matthewdias/solstice/README.md

# solstice
 
40s mods drop-in pcb for equinox

 
 
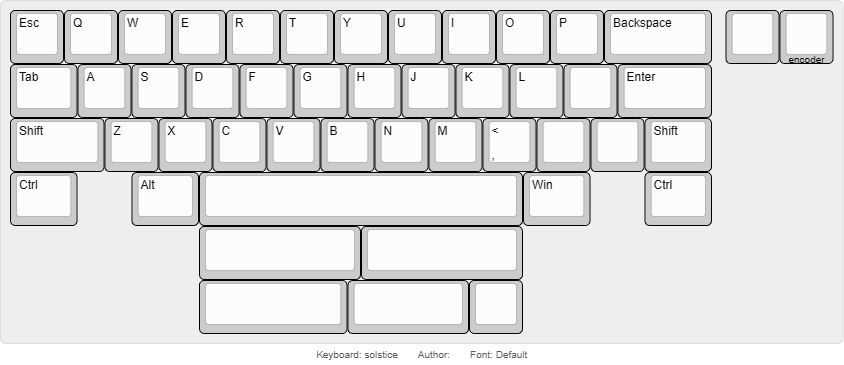
[picture p1: Images/keyboard-layout.png]
