matthewdias/solstice/EquinoxPCB_1.dxf

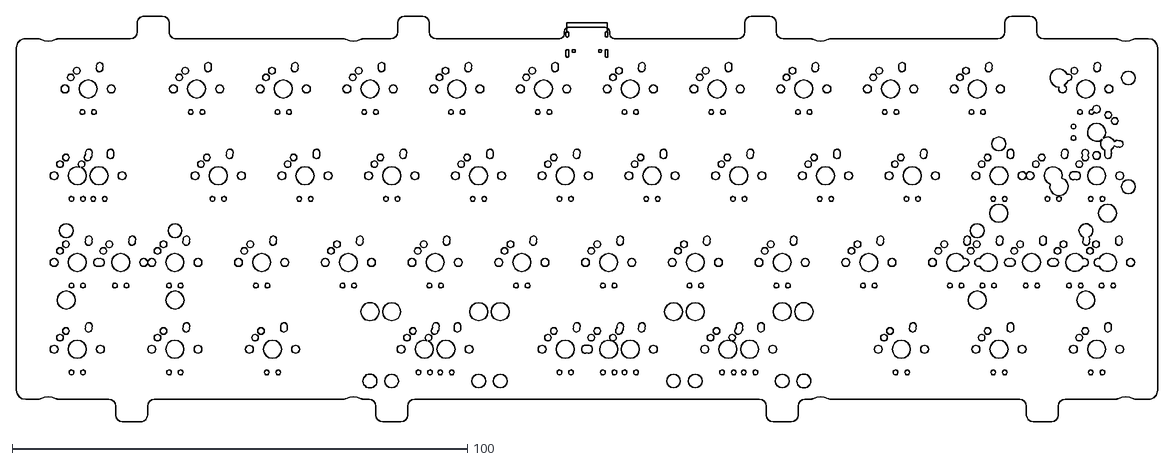
[picture p2: CAD file, 2024-12-08]
EquinoxPCB_1.dxf
250.6 x 89.2
