matthewdias/solstice/solstice.kicad_pcb

## KiCad design solstice.kicad_pcb (2024-12-08)

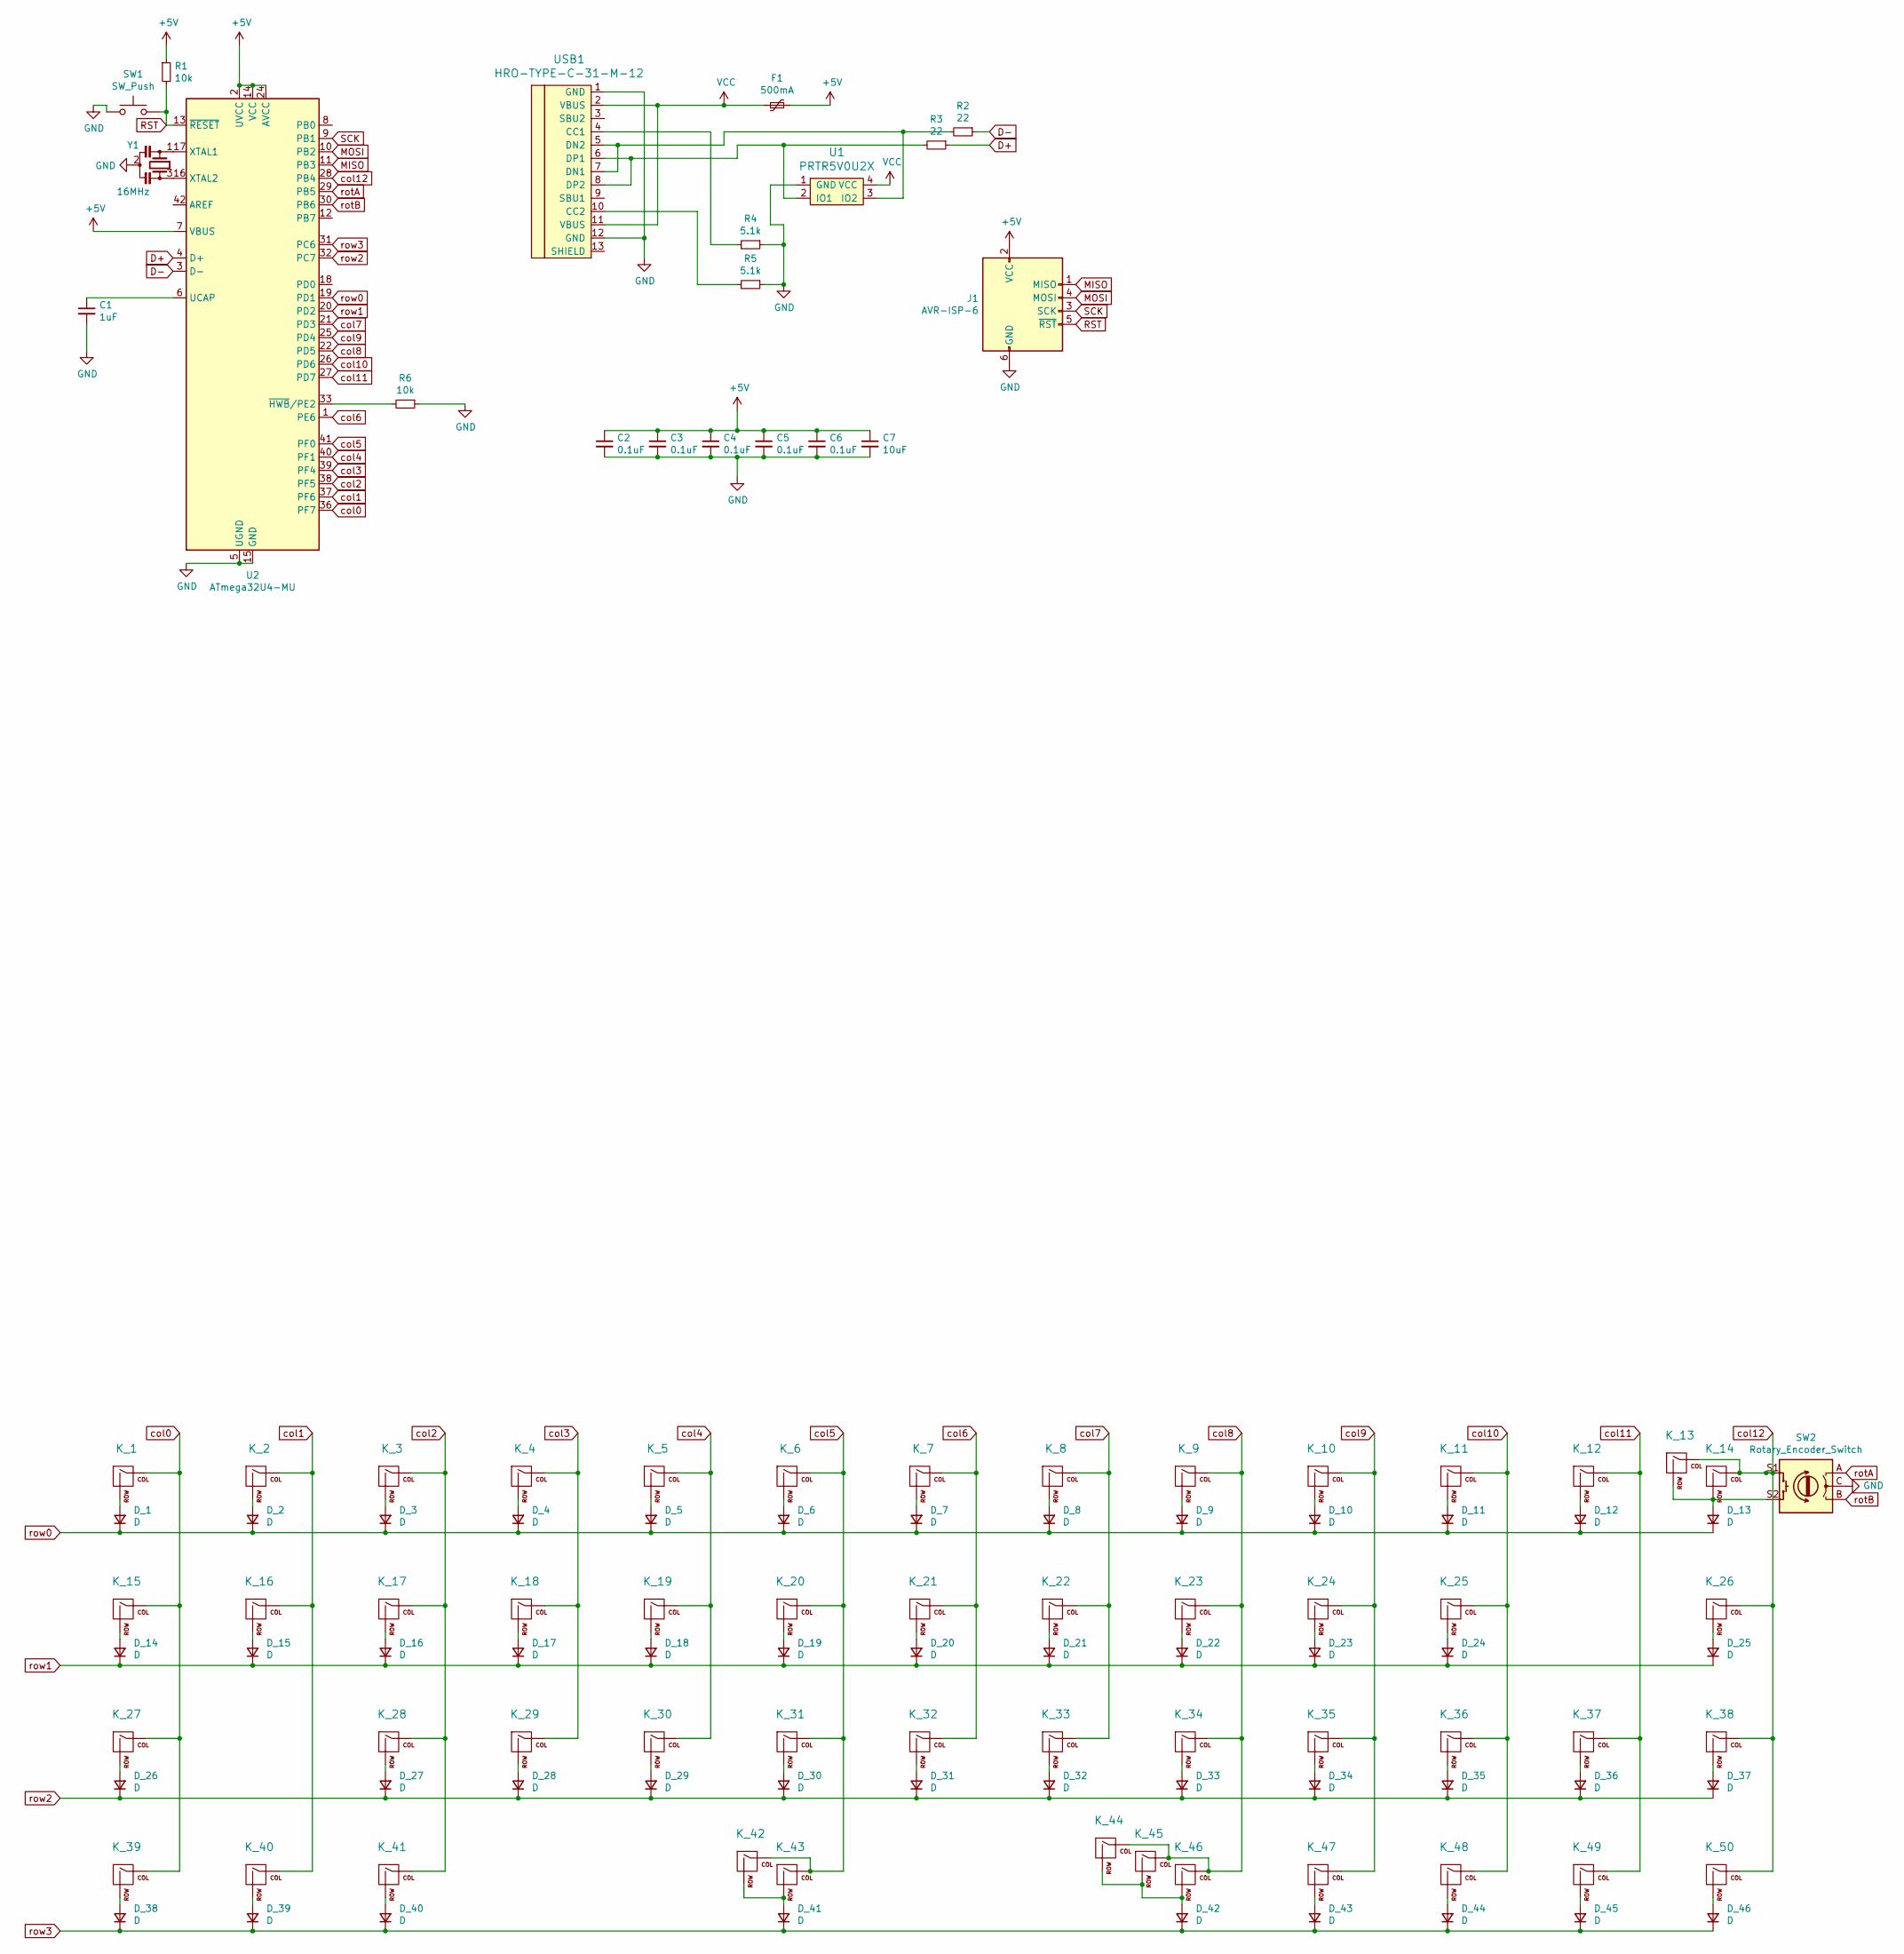
[picture p3: schematic solstice.sch]

Parts:
C1: 1uF; C_0603_1608Metric
C2, C3, C4, C5, C6: 0.1uF; C_0603_1608Metric
C7: 10uF; C_0603_1608Metric
D_1, D_2, D_3, D_4, D_5, D_6, D_7, D_8, D_9, D_10, D_11, D_12, D_13, D_14, D_15, D_16, D_17, D_18, D_19, D_20, D_21, D_22, D_23, D_24, D_25, D_26, D_27, D_28, D_29, D_30, D_31, D_32, D_33, D_34, D_35, D_36, D_37, D_38, D_39, D_40, D_41, D_42, D_43, D_44, D_45, D_46: D; D_SOD-123
F1: 500mA; Fuse_1206_3216Metric
J1: AVR-ISP-6; ISP-Staggered
K_1, K_2, K_3, K_4, K_5, K_6, K_7, K_8, K_9, K_10, K_11, K_12, K_14, K_16, K_17, K_18, K_19, K_20, K_21, K_22, K_23, K_24, K_25, K_28, K_29, K_30, K_31, K_32, K_33, K_34, K_35, K_36, K_37, K_40, K_47, K_49: KEYSW; MXOnly-1U-NoLED
K_13: KEYSW; MXOnly-2U-NoLED
K_15, K_38, K_39, K_41, K_48, K_50: KEYSW; MXOnly-1.25U-NoLED
K_26, K_27: KEYSW; MXOnly-1.75U-NoLED
K_42: KEYSW; MXOnly-2.75U-ReversedStabilizers-NoLED
K_43, K_46: KEYSW; MXOnly-3U-ReversedStabilizers-NoLED
K_44: KEYSW; MXOnly-6U-Centered-ReversedStabilizers-NoLED
K_45: KEYSW; MXOnly-2.25U-ReversedStabilizers-NoLED
R1, R6: 10k; R_0603_1608Metric
R2, R3: 22; R_0603_1608Metric
R4, R5: 5.1k; R_0603_1608Metric
SW1: SW_Push; SKQG-1155865
SW2: Rotary_Encoder_Switch; RotaryEncoder_Alps_EC11E-Switch_Vertical_H20mm_adjusted
U1: PRTR5V0U2X; SOT143B
U2: ATmega32U4-MU; QFN-44-1EP_7x7mm_P0.5mm_EP5.2x5.2mm
USB1: HRO-TYPE-C-31-M-12; HRO-TYPE-C-31-M-12-Assembly
Y1: 16MHz; Resonator_SMD_muRata_CSTxExxV-3Pin_3.0x1.1mm

Connections:
+5V: C2.1, C3.1, C4.1, C5.1, C6.1, C7.1, F1.1, J1.2 (VCC), R1.1, U2.2 (UVCC), U2.7 (VBUS), U2.14 (VCC), U2.24 (AVCC), U2.34 (VCC), U2.44 (AVCC)
D+: R3.1, U2.4 (D+)
D-: R2.1, U2.3 (D-)
GND: C1.2, C2.2, C3.2, C4.2, C5.2, C6.2, C7.2, J1.6 (GND), R4.1, R5.1, R6.1, SW1.1, SW2.C, U1.1 (GND), U2.5 (UGND), U2.15 (GND), U2.23 (GND), U2.35 (GND), U2.43 (GND), U2.45 (GND), USB1.1 (GND), USB1.12 (GND), Y1.2
MISO: J1.1 (MISO), U2.11 (PB3)
MOSI: J1.4 (MOSI), U2.10 (PB2)
unnamed: C1.1, U2.6 (UCAP)
unnamed: D_1.2 (A), K_1.2 (ROW)
unnamed: D_2.2 (A), K_2.2 (ROW)
unnamed: D_3.2 (A), K_3.2 (ROW)
unnamed: D_4.2 (A), K_4.2 (ROW)
unnamed: D_5.2 (A), K_5.2 (ROW)
unnamed: D_6.2 (A), K_6.2 (ROW)
unnamed: D_7.2 (A), K_7.2 (ROW)
unnamed: D_8.2 (A), K_8.2 (ROW)
unnamed: D_9.2 (A), K_9.2 (ROW)
unnamed: D_10.2 (A), K_10.2 (ROW)
unnamed: D_11.2 (A), K_11.2 (ROW)
unnamed: D_12.2 (A), K_12.2 (ROW)
unnamed: D_13.2 (A), K_13.2 (ROW), K_14.2 (ROW), SW2.S2
unnamed: D_14.2 (A), K_15.2 (ROW)
unnamed: D_15.2 (A), K_16.2 (ROW)
unnamed: D_16.2 (A), K_17.2 (ROW)
unnamed: D_17.2 (A), K_18.2 (ROW)
unnamed: D_18.2 (A), K_19.2 (ROW)
unnamed: D_19.2 (A), K_20.2 (ROW)
unnamed: D_20.2 (A), K_21.2 (ROW)
unnamed: D_21.2 (A), K_22.2 (ROW)
unnamed: D_22.2 (A), K_23.2 (ROW)
unnamed: D_23.2 (A), K_24.2 (ROW)
unnamed: D_24.2 (A), K_25.2 (ROW)
unnamed: D_25.2 (A), K_26.2 (ROW)
unnamed: D_26.2 (A), K_27.2 (ROW)
unnamed: D_27.2 (A), K_28.2 (ROW)
unnamed: D_28.2 (A), K_29.2 (ROW)
unnamed: D_29.2 (A), K_30.2 (ROW)
unnamed: D_30.2 (A), K_31.2 (ROW)
unnamed: D_31.2 (A), K_32.2 (ROW)
unnamed: D_32.2 (A), K_33.2 (ROW)
unnamed: D_33.2 (A), K_34.2 (ROW)
unnamed: D_34.2 (A), K_35.2 (ROW)
unnamed: D_35.2 (A), K_36.2 (ROW)
unnamed: D_36.2 (A), K_37.2 (ROW)
unnamed: D_37.2 (A), K_38.2 (ROW)
unnamed: D_38.2 (A), K_39.2 (ROW)
unnamed: D_39.2 (A), K_40.2 (ROW)
unnamed: D_40.2 (A), K_41.2 (ROW)
unnamed: D_41.2 (A), K_42.2 (ROW), K_43.2 (ROW)
unnamed: D_42.2 (A), K_44.2 (ROW), K_45.2 (ROW), K_46.2 (ROW)
unnamed: D_43.2 (A), K_47.2 (ROW)
unnamed: D_44.2 (A), K_48.2 (ROW)
unnamed: D_45.2 (A), K_49.2 (ROW)
unnamed: D_46.2 (A), K_50.2 (ROW)
unnamed: R2.2, U1.3 (IO2), USB1.5 (DN2), USB1.7 (DN1)
unnamed: R3.2, U1.2 (IO1), USB1.6 (DP1), USB1.8 (DP2)
unnamed: R4.2, USB1.4 (CC1)
unnamed: R5.2, USB1.10 (CC2)
unnamed: R6.2, U2.33 (~HWB~/PE2)
unnamed: U2.16 (XTAL2), Y1.3
unnamed: U2.17 (XTAL1), Y1.1
RST: J1.5 (~RST), R1.2, SW1.2, U2.13 (~RESET)
SCK: J1.3 (SCK), U2.9 (PB1)
VCC: F1.2, U1.4 (VCC), USB1.2 (VBUS), USB1.11 (VBUS)
col0: K_1.1 (COL), K_15.1 (COL), K_27.1 (COL), K_39.1 (COL), U2.36 (PF7)
col1: K_2.1 (COL), K_16.1 (COL), K_40.1 (COL), U2.37 (PF6)
col2: K_3.1 (COL), K_17.1 (COL), K_28.1 (COL), K_41.1 (COL), U2.38 (PF5)
col3: K_4.1 (COL), K_18.1 (COL), K_29.1 (COL), U2.39 (PF4)
col4: K_5.1 (COL), K_19.1 (COL), K_30.1 (COL), U2.40 (PF1)
col5: K_6.1 (COL), K_20.1 (COL), K_31.1 (COL), K_42.1 (COL), K_43.1 (COL), U2.41 (PF0)
col6: K_7.1 (COL), K_21.1 (COL), K_32.1 (COL), U2.1 (PE6)
col7: K_8.1 (COL), K_22.1 (COL), K_33.1 (COL), U2.21 (PD3)
col8: K_9.1 (COL), K_23.1 (COL), K_34.1 (COL), K_44.1 (COL), K_45.1 (COL), K_46.1 (COL), U2.22 (PD5)
col9: K_10.1 (COL), K_24.1 (COL), K_35.1 (COL), K_47.1 (COL), U2.25 (PD4)
col10: K_11.1 (COL), K_25.1 (COL), K_36.1 (COL), K_48.1 (COL), U2.26 (PD6)
col11: K_12.1 (COL), K_37.1 (COL), K_49.1 (COL), U2.27 (PD7)
col12: K_13.1 (COL), K_14.1 (COL), K_26.1 (COL), K_38.1 (COL), K_50.1 (COL), SW2.S1, U2.28 (PB4)
rotA: SW2.A, U2.29 (PB5)
rotB: SW2.B, U2.30 (PB6)
row0: D_1.1 (K), D_2.1 (K), D_3.1 (K), D_4.1 (K), D_5.1 (K), D_6.1 (K), D_7.1 (K), D_8.1 (K), D_9.1 (K), D_10.1 (K), D_11.1 (K), D_12.1 (K), D_13.1 (K), U2.19 (PD1)
row1: D_14.1 (K), D_15.1 (K), D_16.1 (K), D_17.1 (K), D_18.1 (K), D_19.1 (K), D_20.1 (K), D_21.1 (K), D_22.1 (K), D_23.1 (K), D_24.1 (K), D_25.1 (K), U2.20 (PD2)
row2: D_26.1 (K), D_27.1 (K), D_28.1 (K), D_29.1 (K), D_30.1 (K), D_31.1 (K), D_32.1 (K), D_33.1 (K), D_34.1 (K), D_35.1 (K), D_36.1 (K), D_37.1 (K), U2.32 (PC7)
row3: D_38.1 (K), D_39.1 (K), D_40.1 (K), D_41.1 (K), D_42.1 (K), D_43.1 (K), D_44.1 (K), D_45.1 (K), D_46.1 (K), U2.31 (PC6)

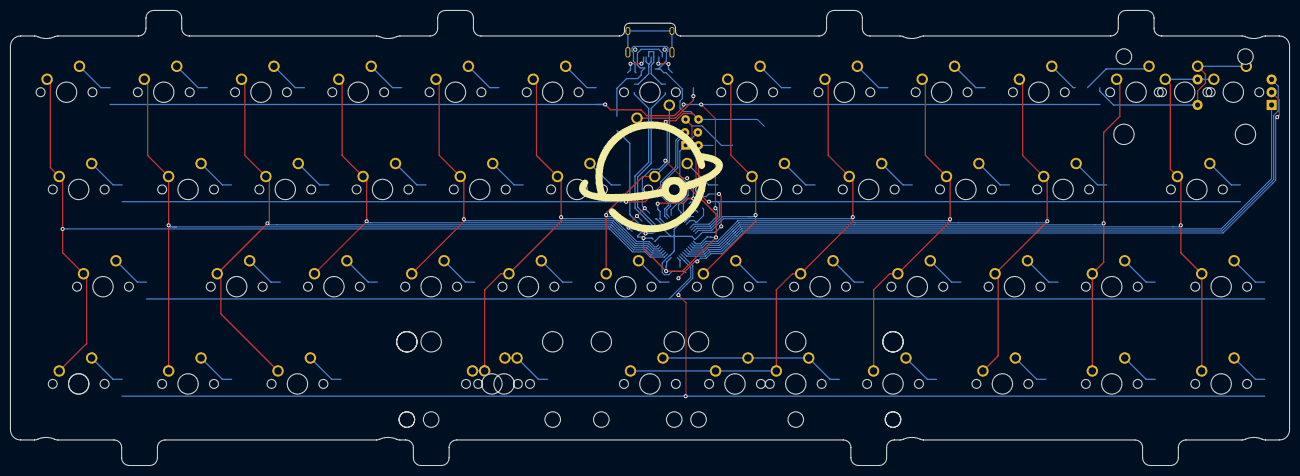
[picture p4: board solstice.kicad_pcb from above]

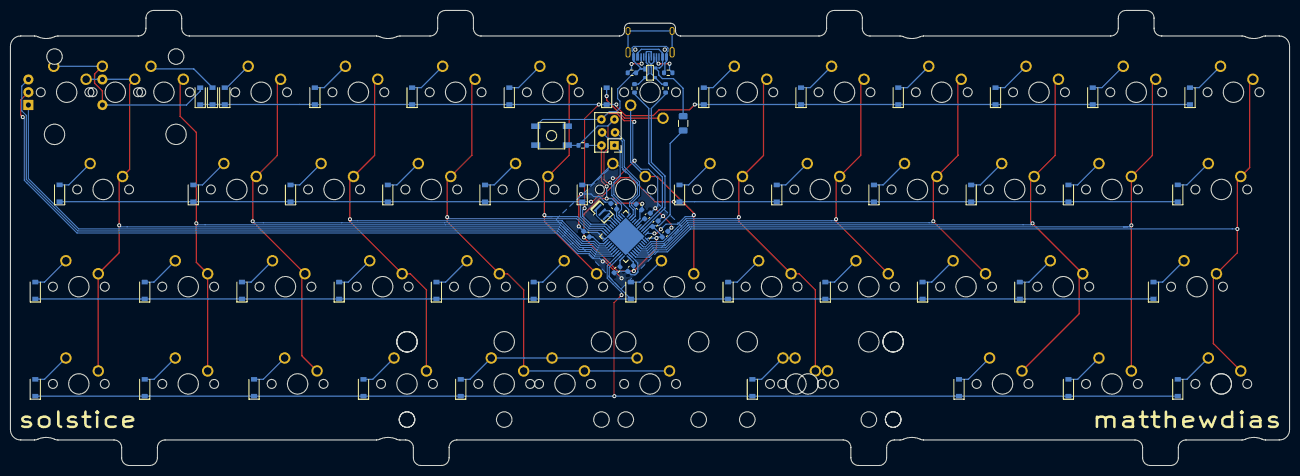
[picture p5: board solstice.kicad_pcb from below]

Board: 2 copper layers, 250.6 x 89.2 mm, 117 parts (66 on the bottom side), 82 nets.
